rivques/web-programmable-pid-car/README.md

# wireless-tuneable-pid-car
Docs for this project are available [on River's website](https://rivques.dev/high-school-engineering/wireless-tuneable-pid-car/) and on [this GitHub repo](https://github.com/rivques/wireless-tuneable-pid-car/blob/main/docs/index.md).
