rivques/web-programmable-pid-car/docs/WTPIDC/car-iso.jpeg

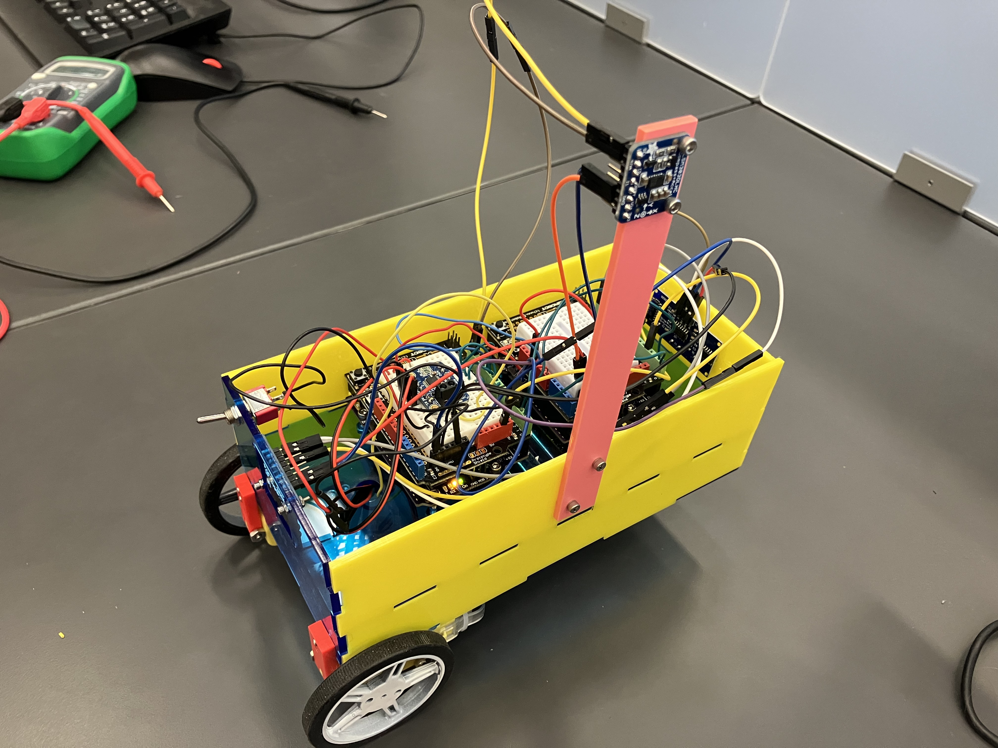
docs/WTPIDC/car-iso.jpeg
