rivques/web-programmable-pid-car/(list of files, drawings)

Other design files:
docs/circuit.fzz
