rivques/web-programmable-pid-car/(commit log)

2023-04-14 basic BLE UART echo
2023-04-21 begin integrating PID
2023-04-21 more PID comms but failing WS keepalive again >:(
    [index.js]
2023-04-24 cad updates
2023-04-25 get most of car-controller except for motor drivers
2023-04-25 fix a little data lifetime issue
    [car-controller.py]
2023-05-01 add motors and begin live chart
2023-05-02 reset i term on gain change
    [car-controller.py]
2023-05-09 add watchdog timer
2023-05-18 add docs framework
2023-05-22 add fritzing diagram
    [circuit.fzz]
2023-06-02 Add link to CAD
